soapbar/team8s/README.md

# ECE 3400: Physical Intelligent Systems 
Taught by Professor Kirstin Petersen

Fall 2018

## Team #8 : team8s
We are a group of four students working together on a semester-long physical intelligent systems project. 

### Used Bootstrap template [Half Slider](https://startbootstrap.com/template-overviews/half-slider/)
