soapbar/team8s/docs/images/box.JPG

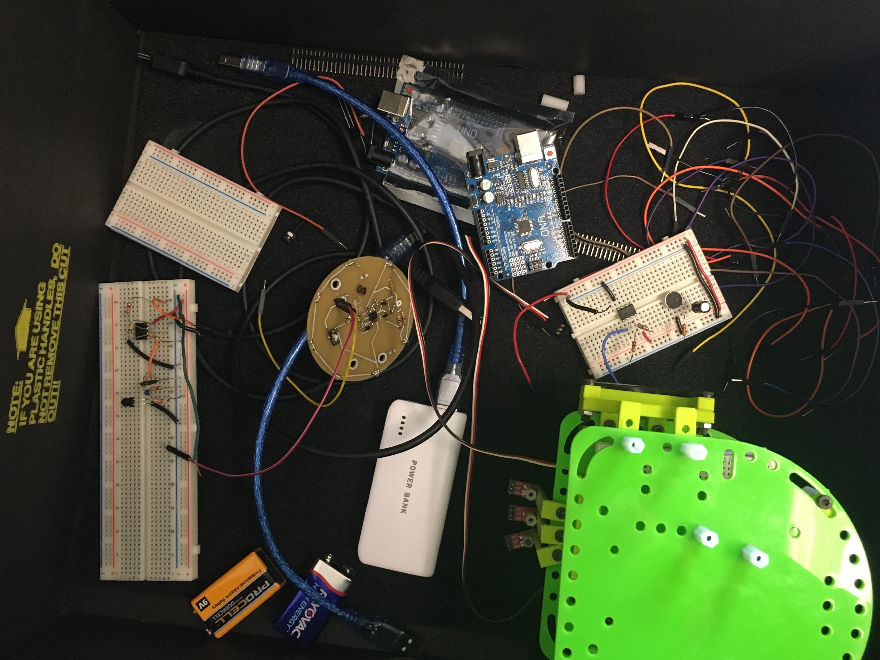
docs/images/box.JPG
