soapbar/team8s/docs/images/computers.JPG

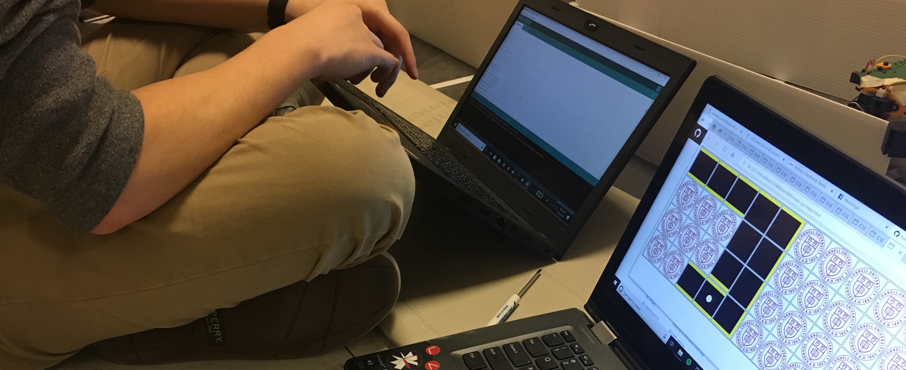
docs/images/computers.JPG
