soapbar/team8s/docs/images/current-robo.JPG

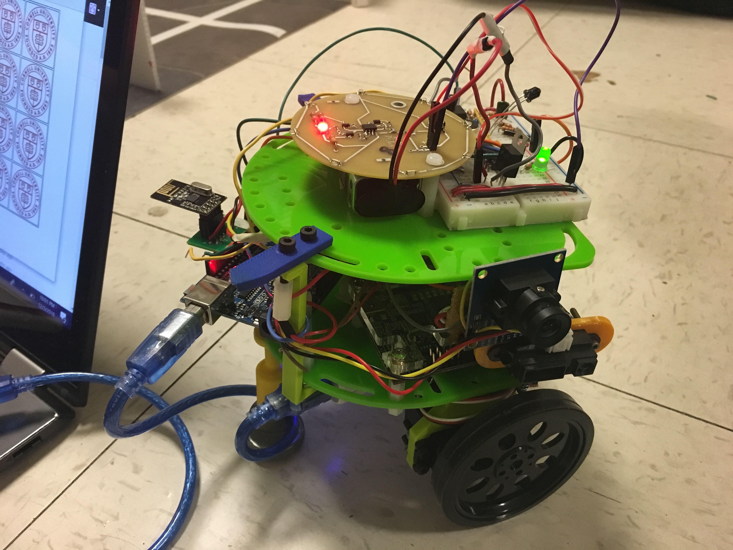
docs/images/current-robo.JPG
