soapbar/team8s/docs/images/current_robot_1120.JPG

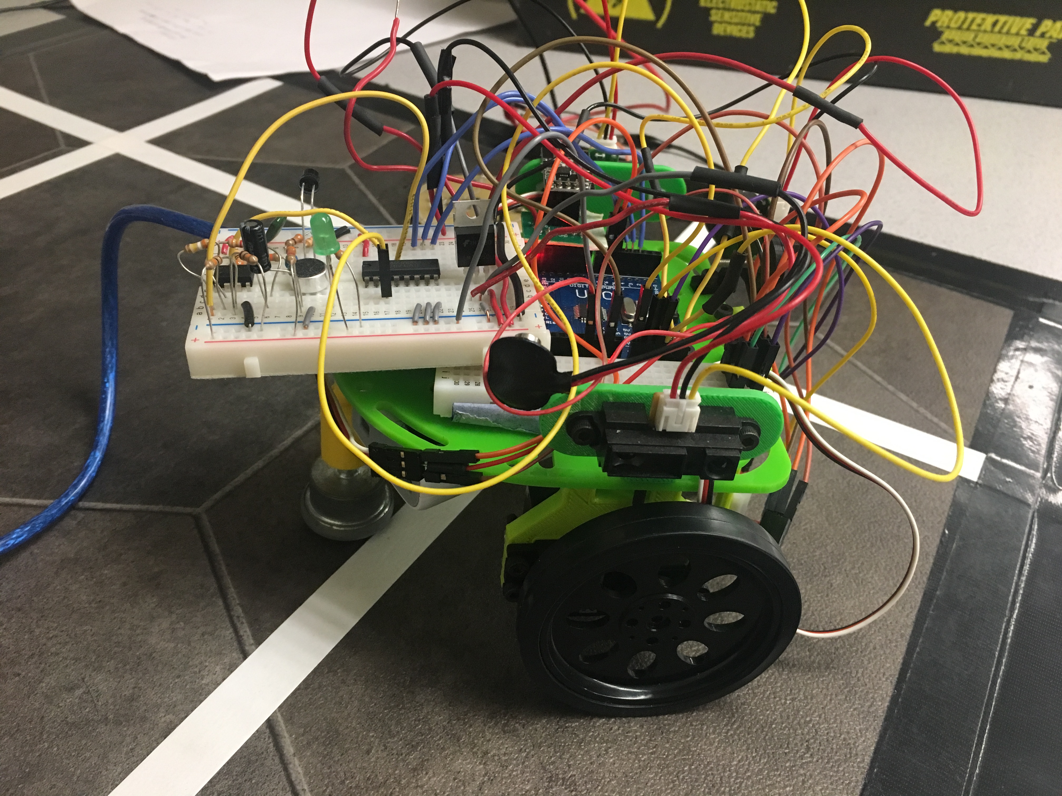
docs/images/current_robot_1120.JPG
