soapbar/team8s/docs/images/final/camera.png

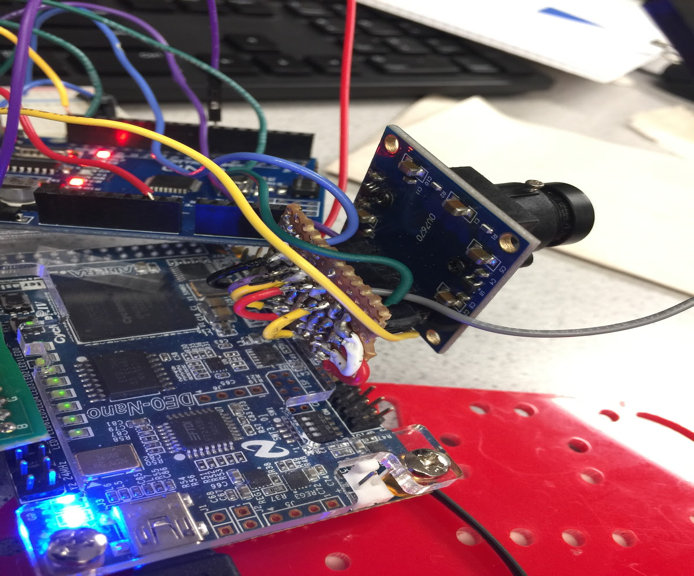
docs/images/final/camera.png
