soapbar/team8s/docs/images/final/group-pic.JPG

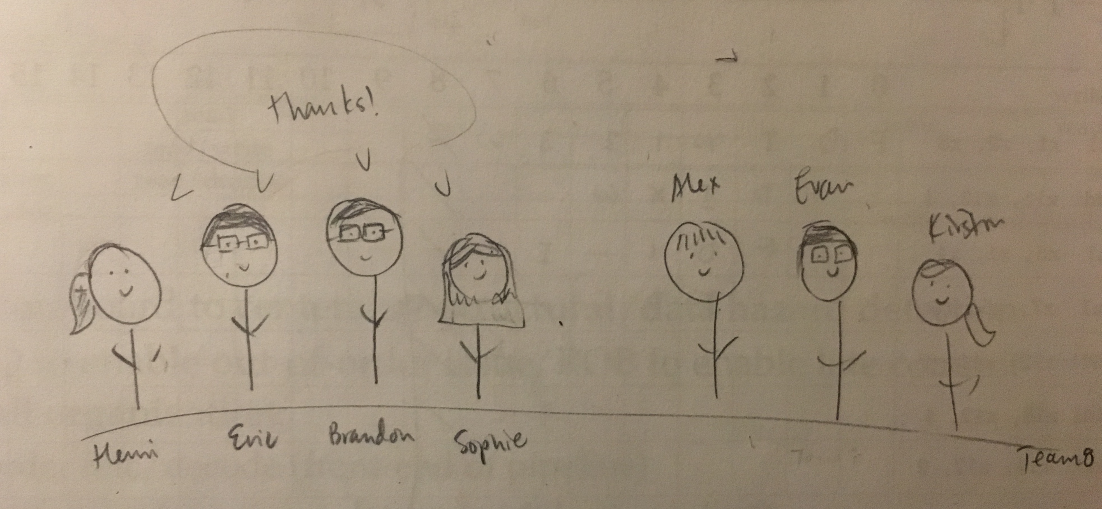
docs/images/final/group-pic.JPG
