soapbar/team8s/docs/images/final/gui-2.png

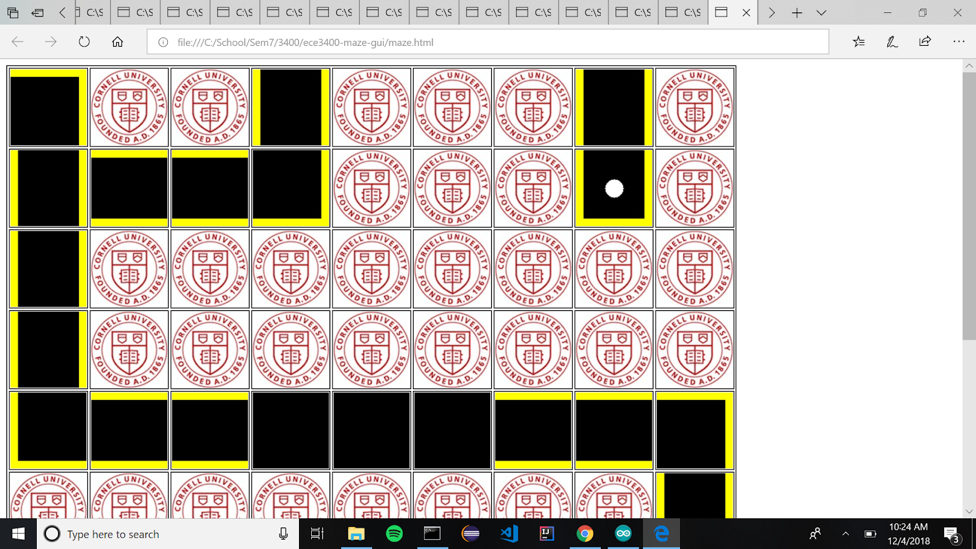
docs/images/final/gui-2.png
