soapbar/team8s/docs/images/final/ir.png

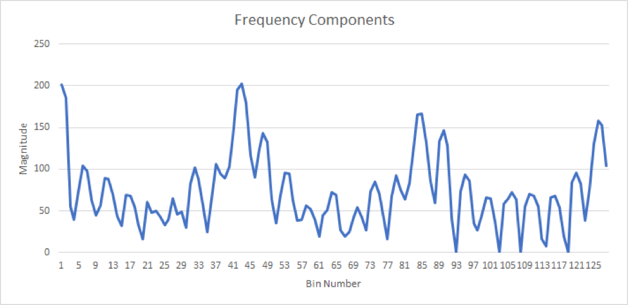
docs/images/final/ir.png
