soapbar/team8s/docs/images/final/line-following-1.png

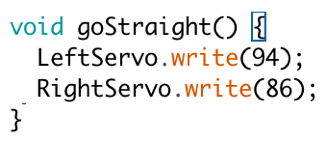
docs/images/final/line-following-1.png
