soapbar/team8s/docs/images/final/line-following.png

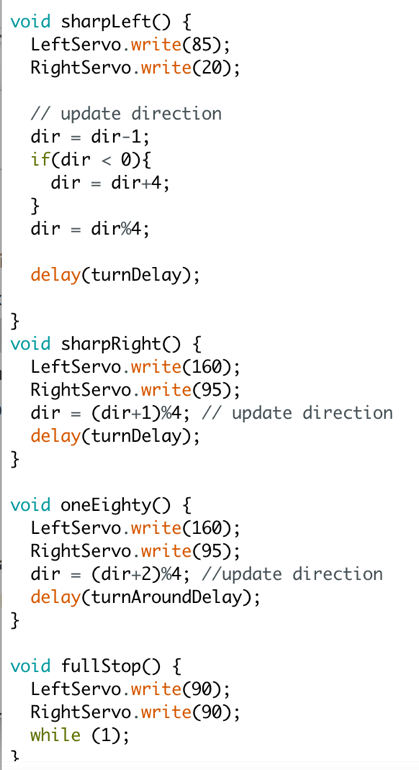
docs/images/final/line-following.png
