soapbar/team8s/docs/images/final/mic.png

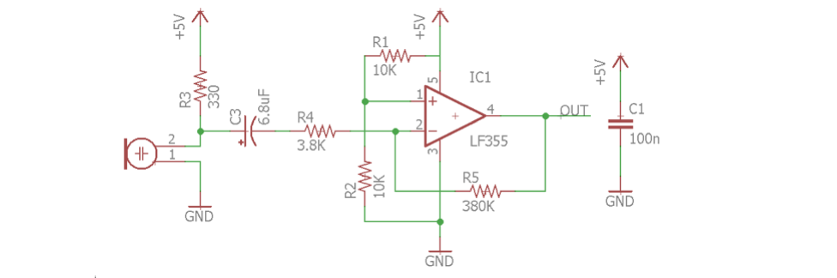
docs/images/final/mic.png
