soapbar/team8s/docs/images/final/team.png

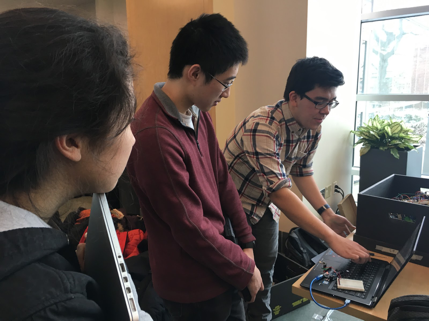
docs/images/final/team.png
