soapbar/team8s/docs/images/lab1/external_led.png

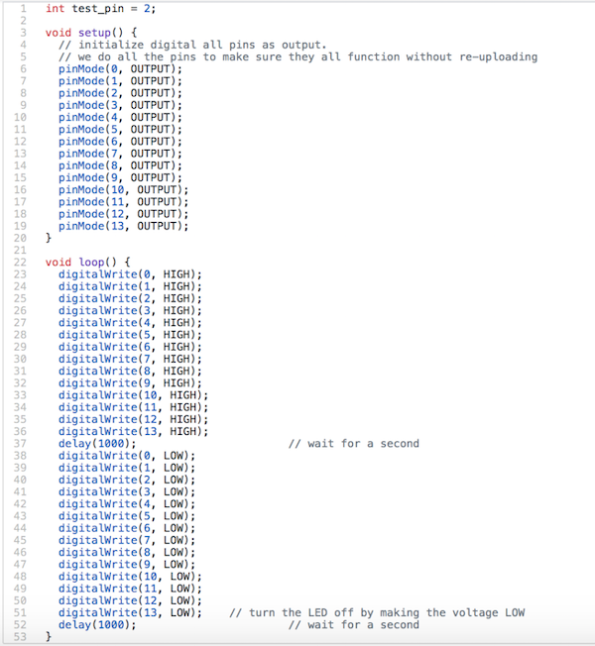
docs/images/lab1/external_led.png
