soapbar/team8s/docs/images/lab2/acoustic_diagram.png

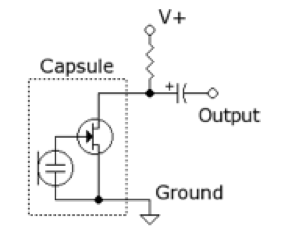
docs/images/lab2/acoustic_diagram.png
