soapbar/team8s/docs/images/lab2/acoustic_graph.png

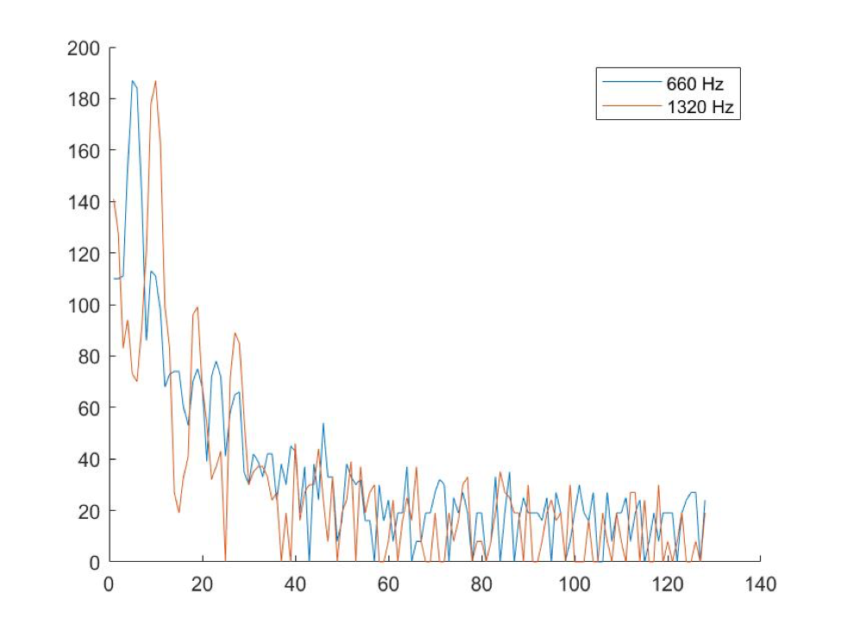
docs/images/lab2/acoustic_graph.png
