soapbar/team8s/docs/images/lab2/bandpass_filter.png

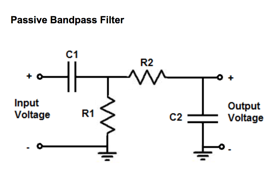
docs/images/lab2/bandpass_filter.png
