soapbar/team8s/docs/images/lab2/fft_code_detection.png

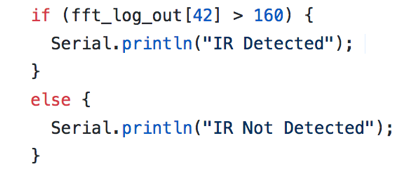
docs/images/lab2/fft_code_detection.png
