soapbar/team8s/docs/images/lab2/final_circuit.png

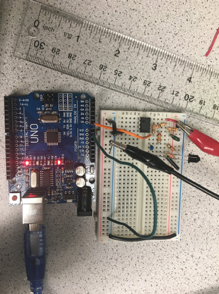
docs/images/lab2/final_circuit.png
