soapbar/team8s/docs/images/lab2/initial_circuit.png

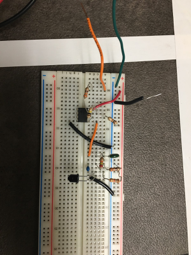
docs/images/lab2/initial_circuit.png
