soapbar/team8s/docs/images/lab2/noninverting_opamp.png

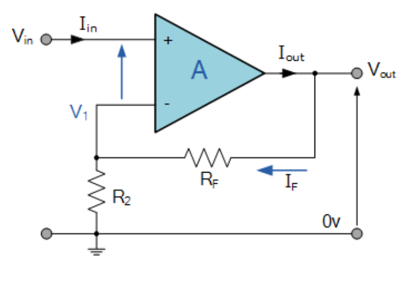
docs/images/lab2/noninverting_opamp.png
