soapbar/team8s/docs/images/lab2/pinout.png

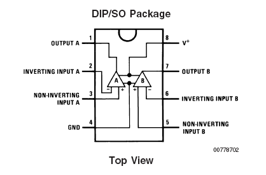
docs/images/lab2/pinout.png
