soapbar/team8s/docs/images/lab2/reposition.png

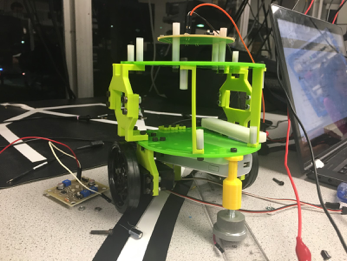
docs/images/lab2/reposition.png
