soapbar/team8s/docs/images/lab2/scope.png

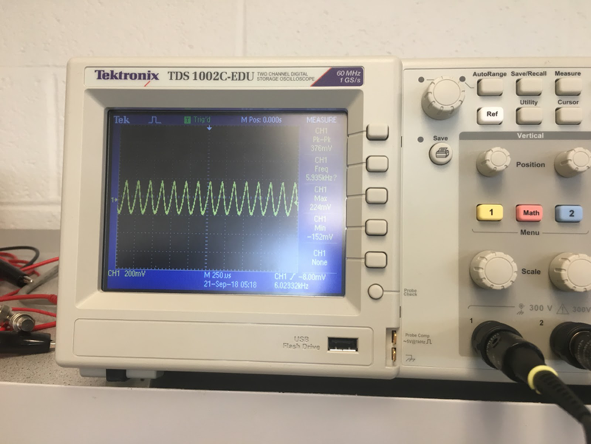
docs/images/lab2/scope.png
