soapbar/team8s/docs/images/lab4/arduino_pins.png

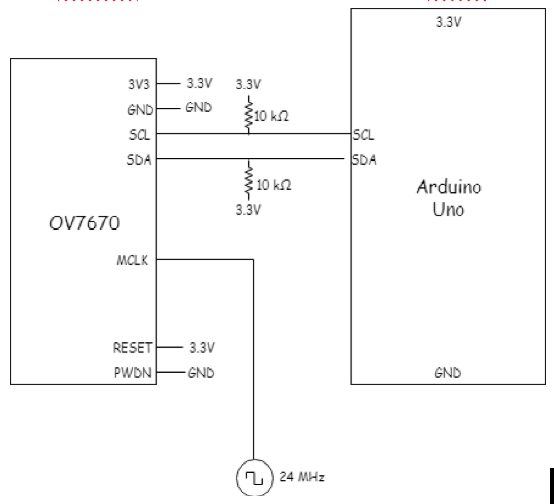
docs/images/lab4/arduino_pins.png
