soapbar/team8s/docs/images/lab4/color_bar.JPG

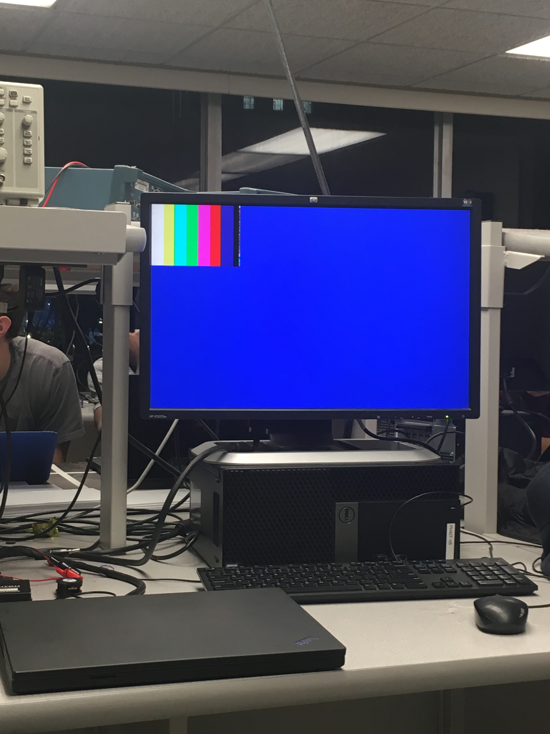
docs/images/lab4/color_bar.JPG
