soapbar/team8s/docs/images/lab4/flag-camera.png

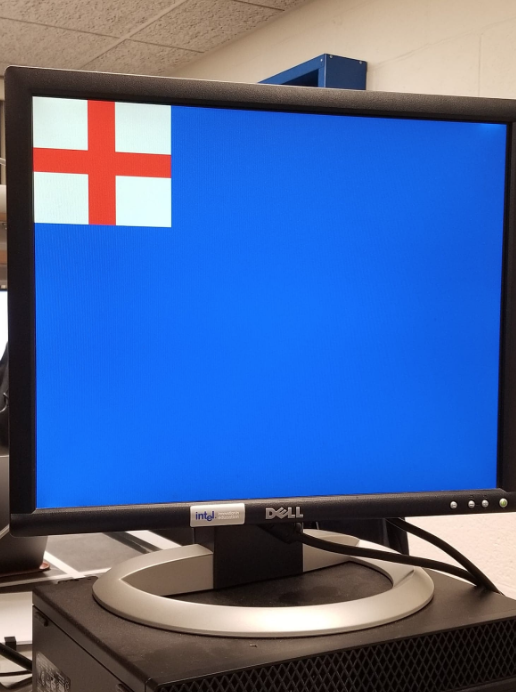
docs/images/lab4/flag-camera.png
