soapbar/team8s/docs/images/lab4/frame-sync.png

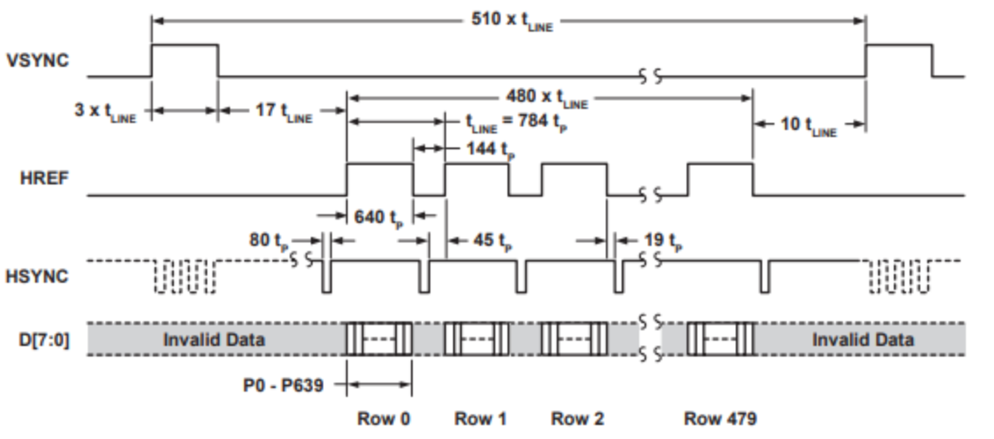
docs/images/lab4/frame-sync.png
