soapbar/team8s/docs/images/lab4/pixel-data-code.png

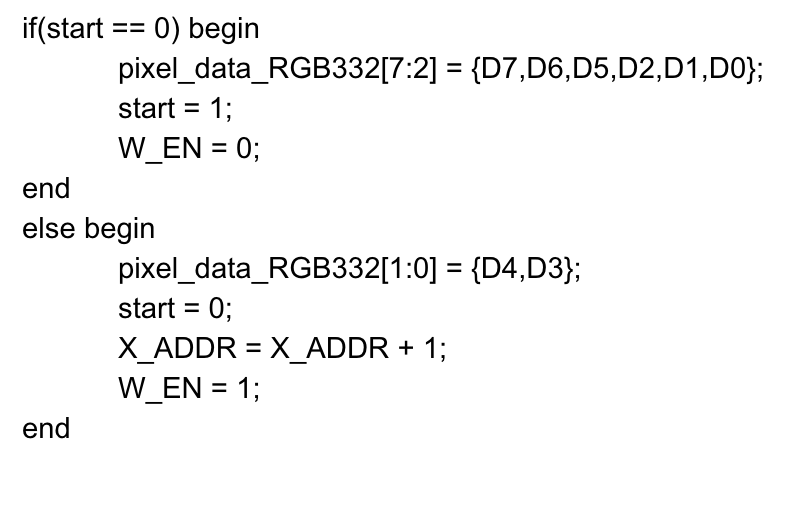
docs/images/lab4/pixel-data-code.png
