soapbar/team8s/docs/images/lab4/red-blue-pixel-code.png

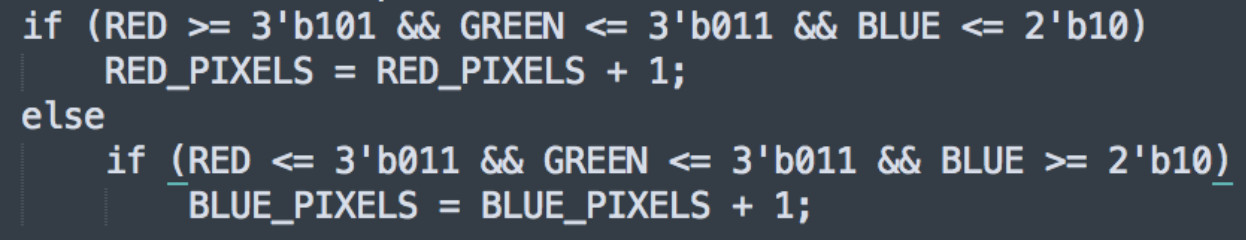
docs/images/lab4/red-blue-pixel-code.png
