soapbar/team8s/docs/images/lab4/timing-diagram.png

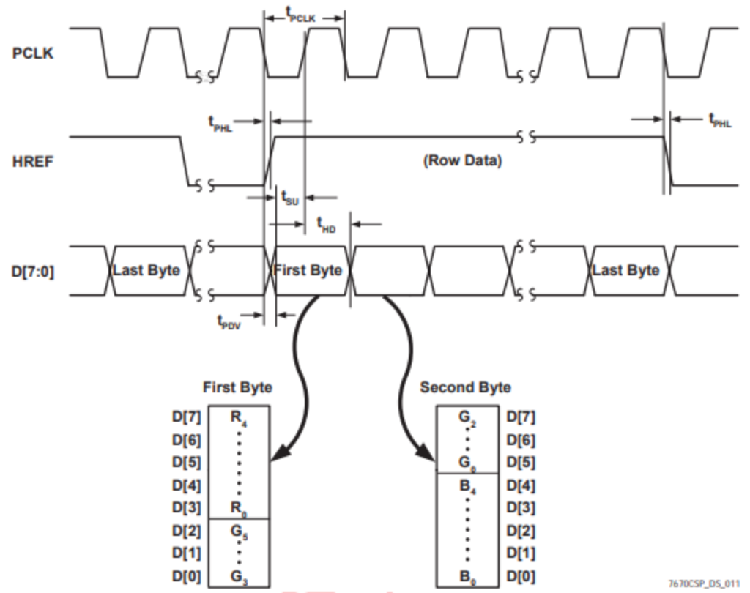
docs/images/lab4/timing-diagram.png
