soapbar/team8s/docs/images/lab.JPG

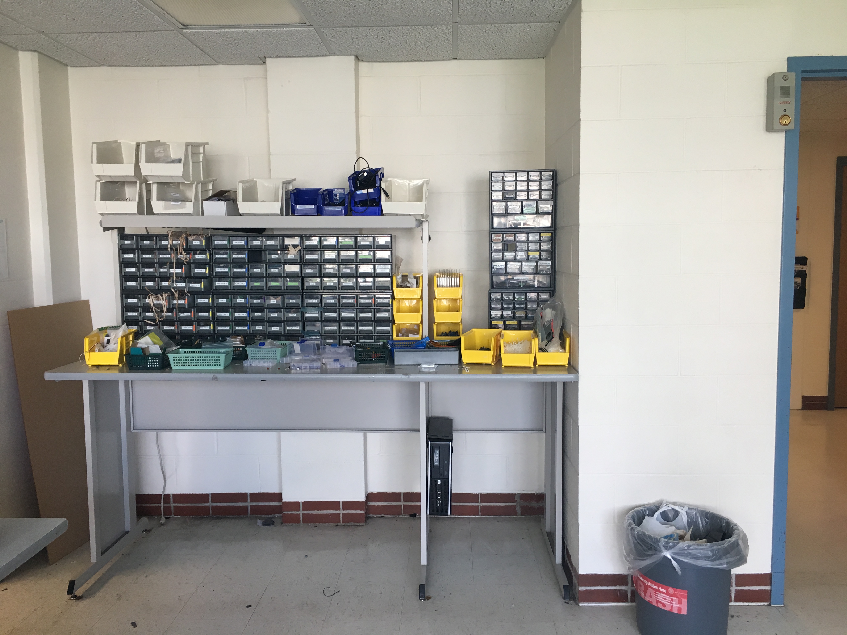
docs/images/lab.JPG
