soapbar/team8s/docs/images/milestone1/figure8_code.png

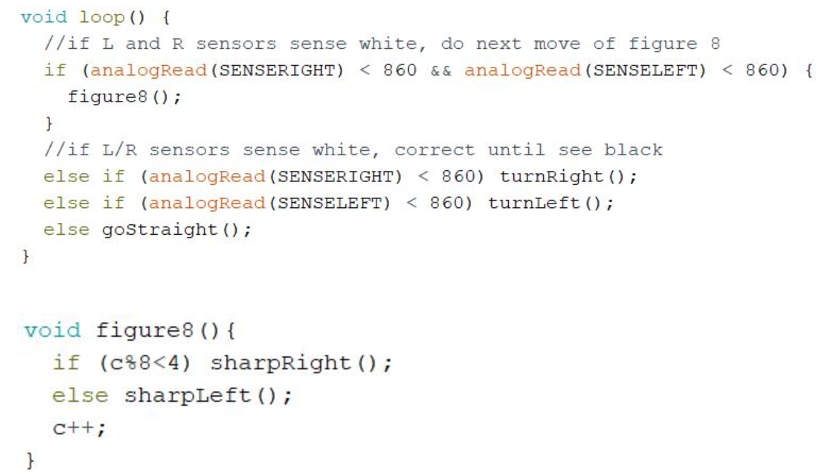
docs/images/milestone1/figure8_code.png
