soapbar/team8s/docs/images/milestone3/dfs-1.png

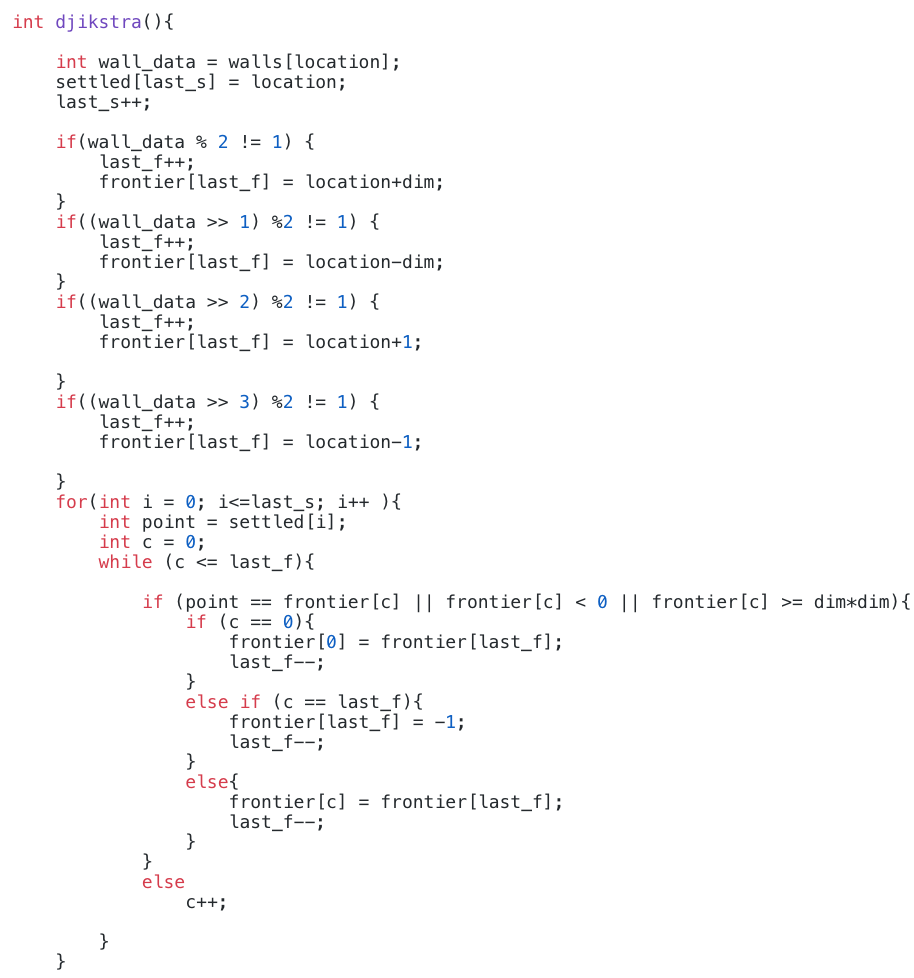
docs/images/milestone3/dfs-1.png
