soapbar/team8s/docs/images/milestone3/dfs-2.png

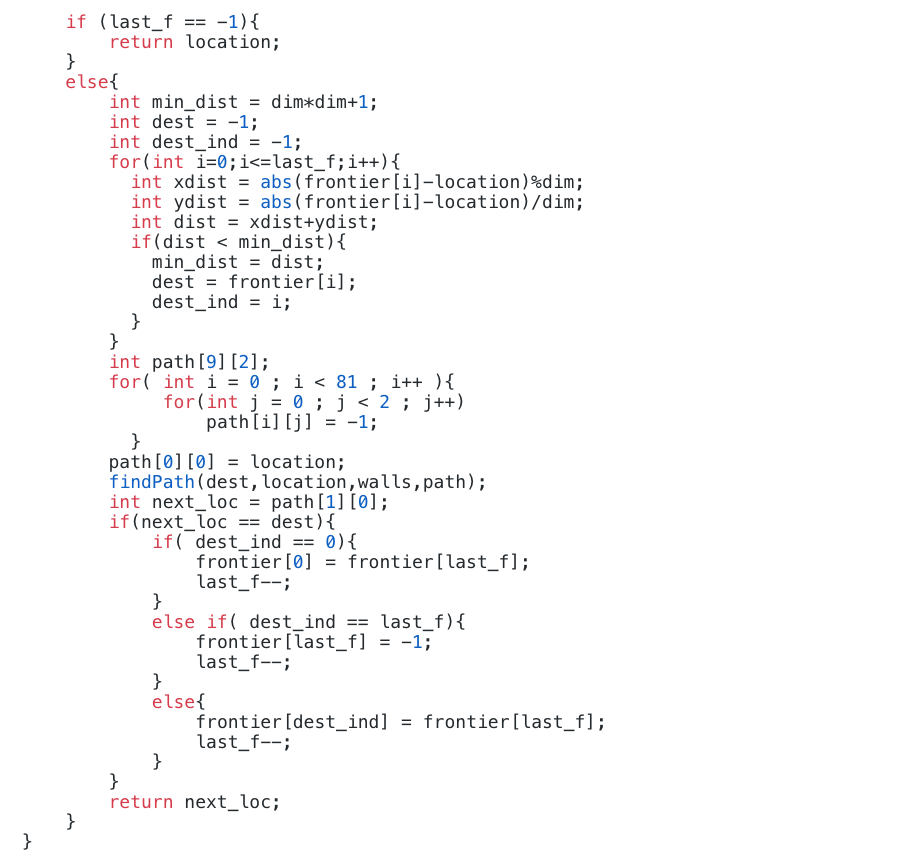
docs/images/milestone3/dfs-2.png
