soapbar/team8s/docs/images/milestone4/camera-part-1.JPG

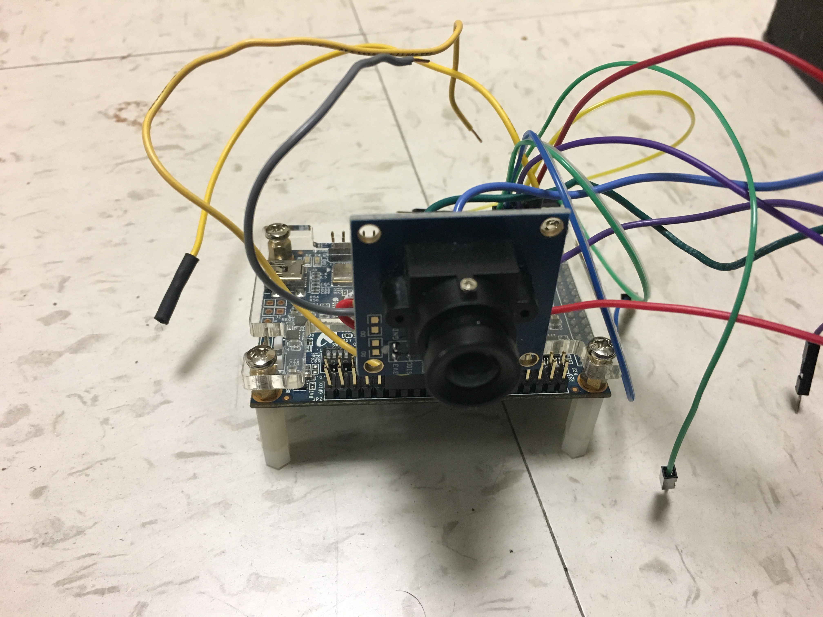
docs/images/milestone4/camera-part-1.JPG
