soapbar/team8s/docs/images/milestone4/camera-part-2.JPG

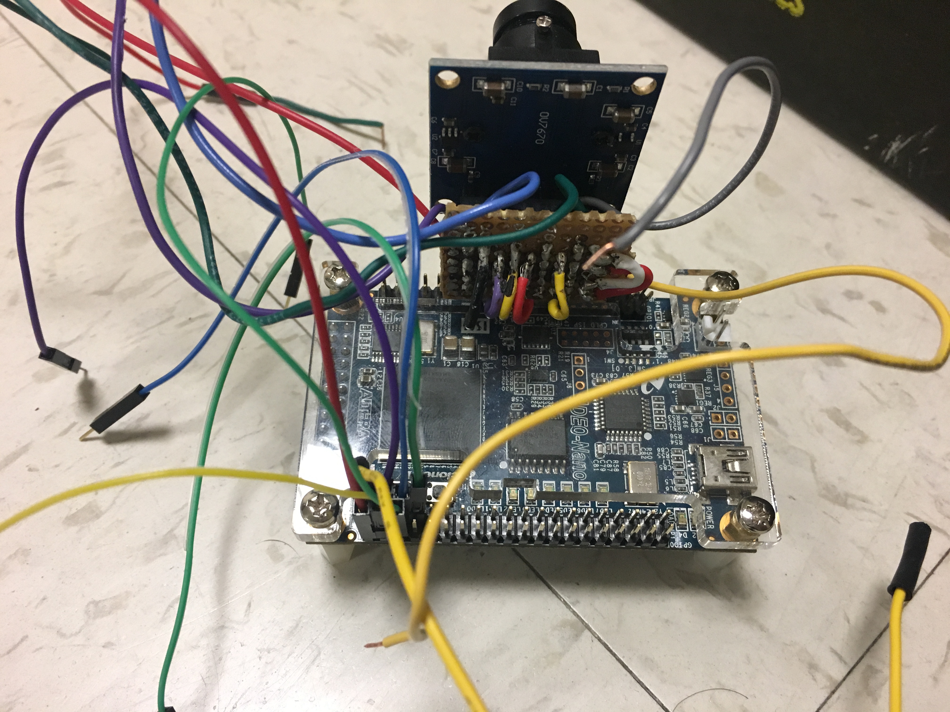
docs/images/milestone4/camera-part-2.JPG
