soapbar/team8s/docs/images/random-pics/brandon-walking.JPG

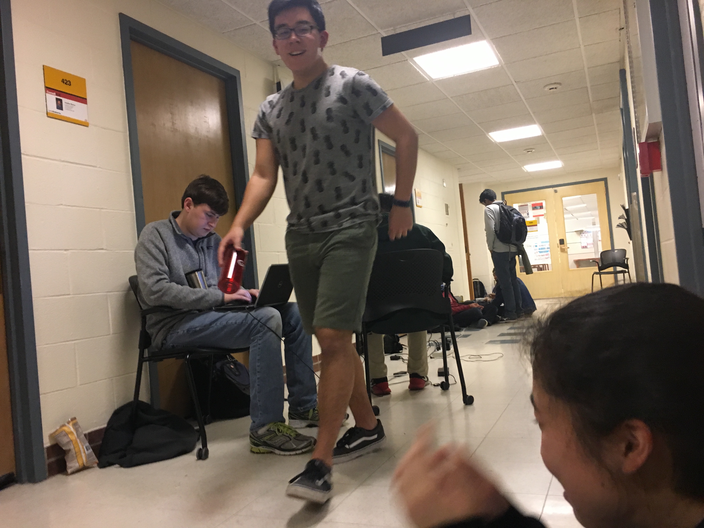
docs/images/random-pics/brandon-walking.JPG
