soapbar/team8s/docs/images/random-pics/eric.JPG

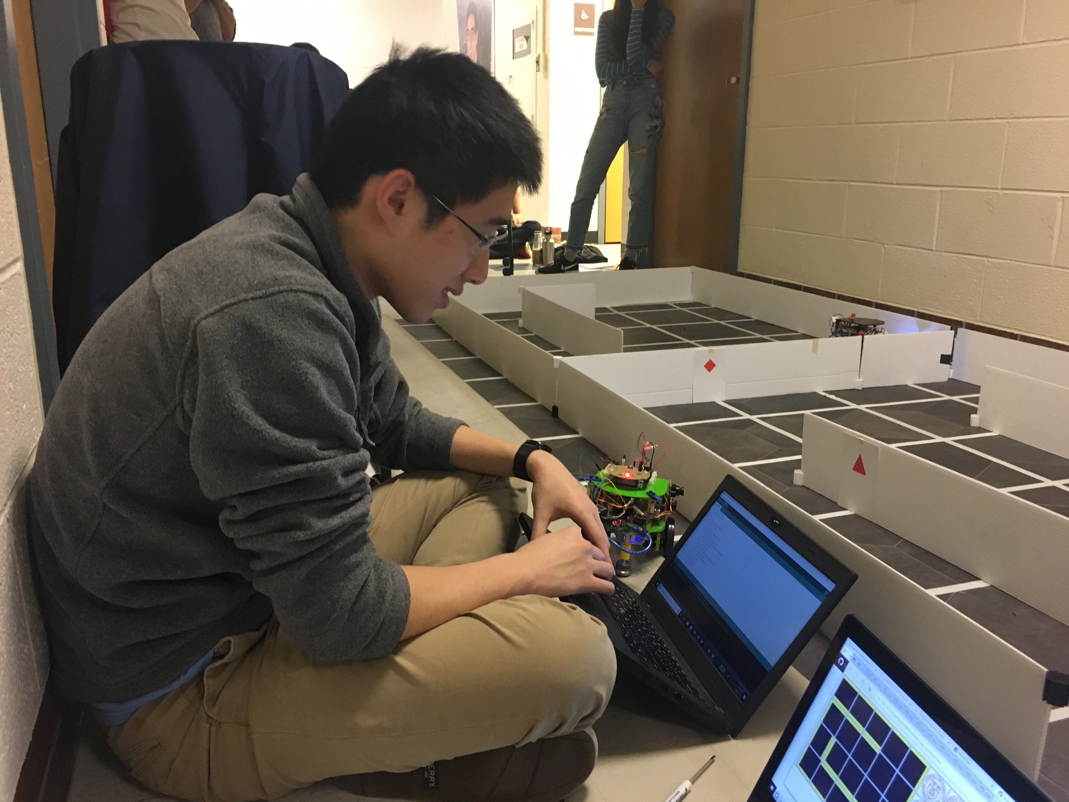
docs/images/random-pics/eric.JPG
