soapbar/team8s/docs/images/random-pics/henri.JPG

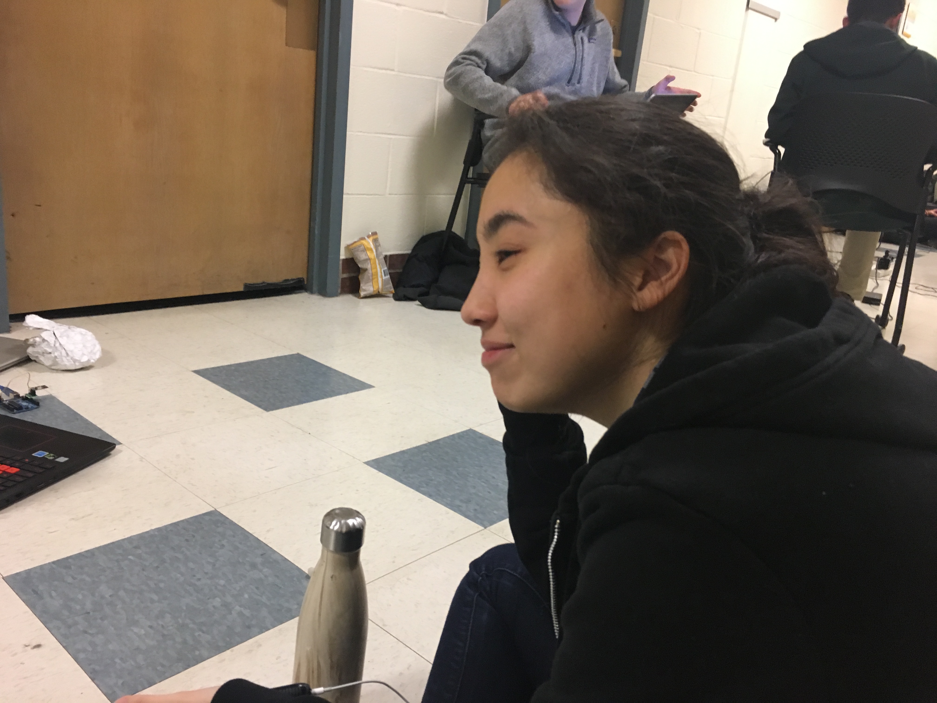
docs/images/random-pics/henri.JPG
