soapbar/team8s/docs/images/robot.JPG

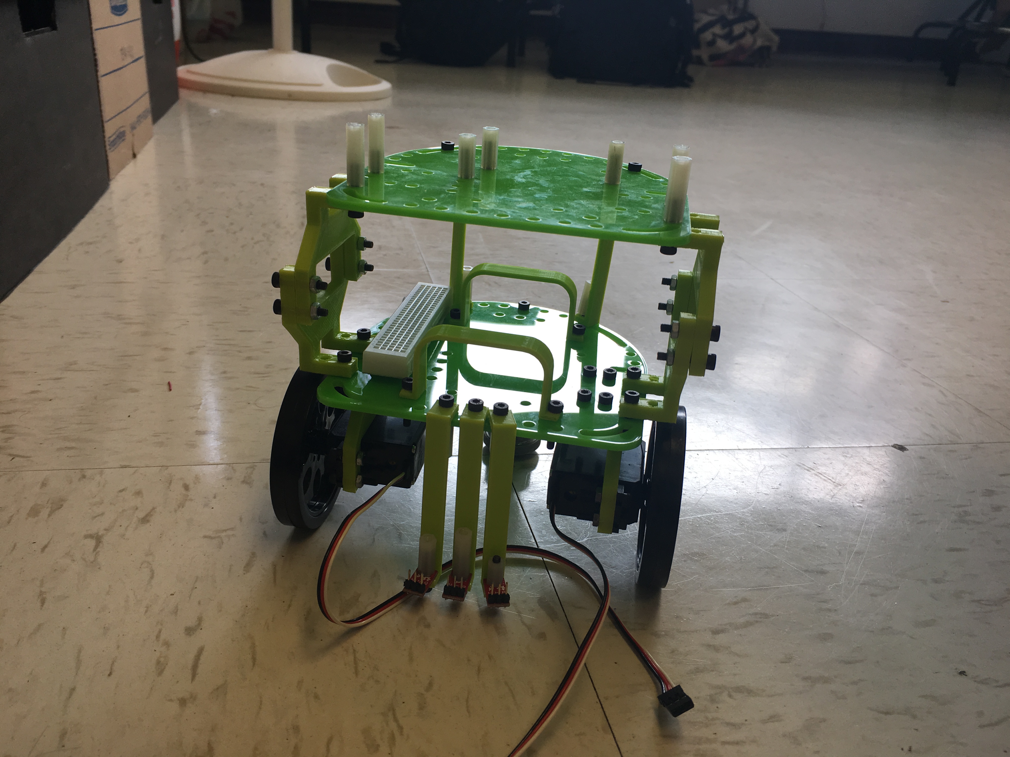
docs/images/robot.JPG
