soapbar/team8s/docs/images/team/brandon.jpg

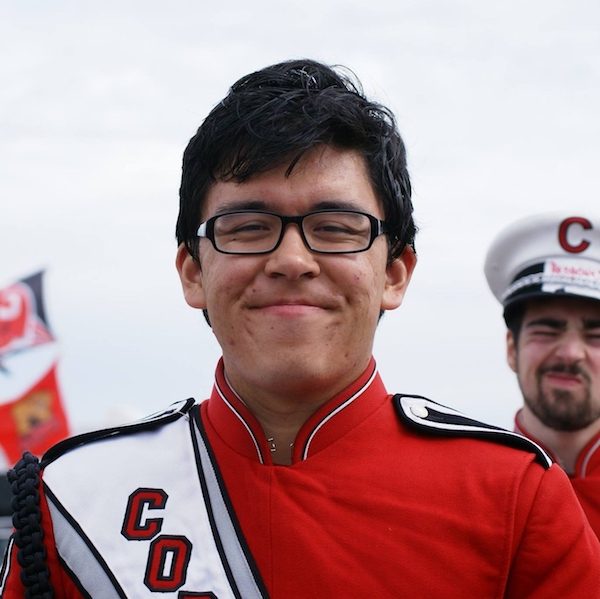
docs/images/team/brandon.jpg
