soapbar/team8s/docs/images/team/eric.jpg

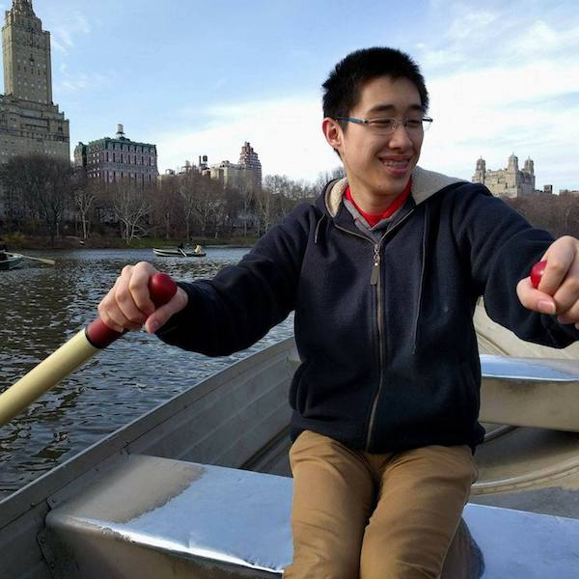
docs/images/team/eric.jpg
