soapbar/team8s/docs/images/team/henri.jpg

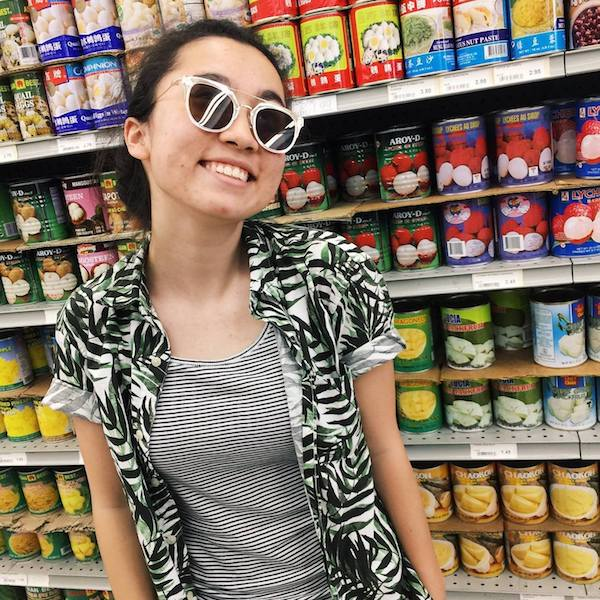
docs/images/team/henri.jpg
