soapbar/team8s/docs/images/team/sophie.jpg

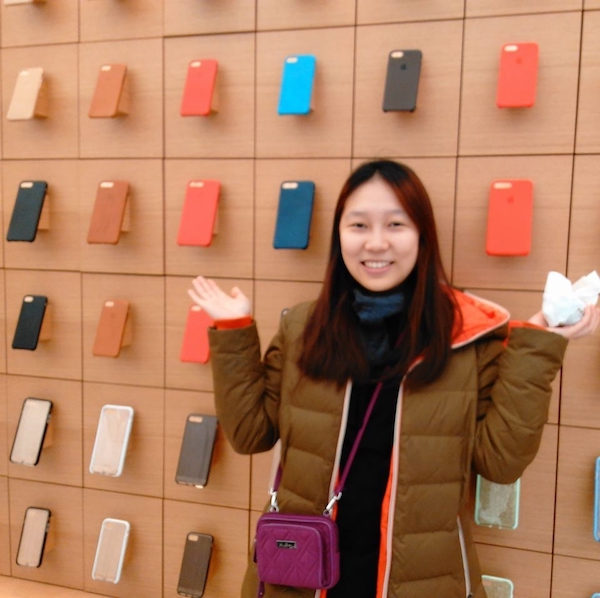
docs/images/team/sophie.jpg
