soapbar/team8s/docs/images/traversalCode.png

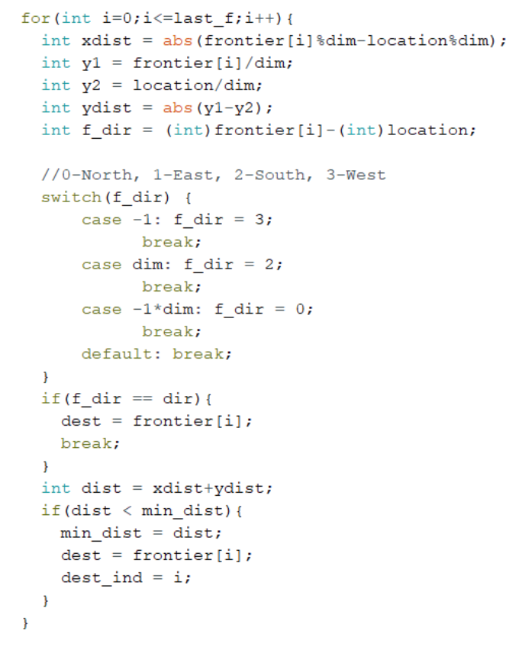
docs/images/traversalCode.png
