soapbar/team8s/docs/images/workingTraversal.png

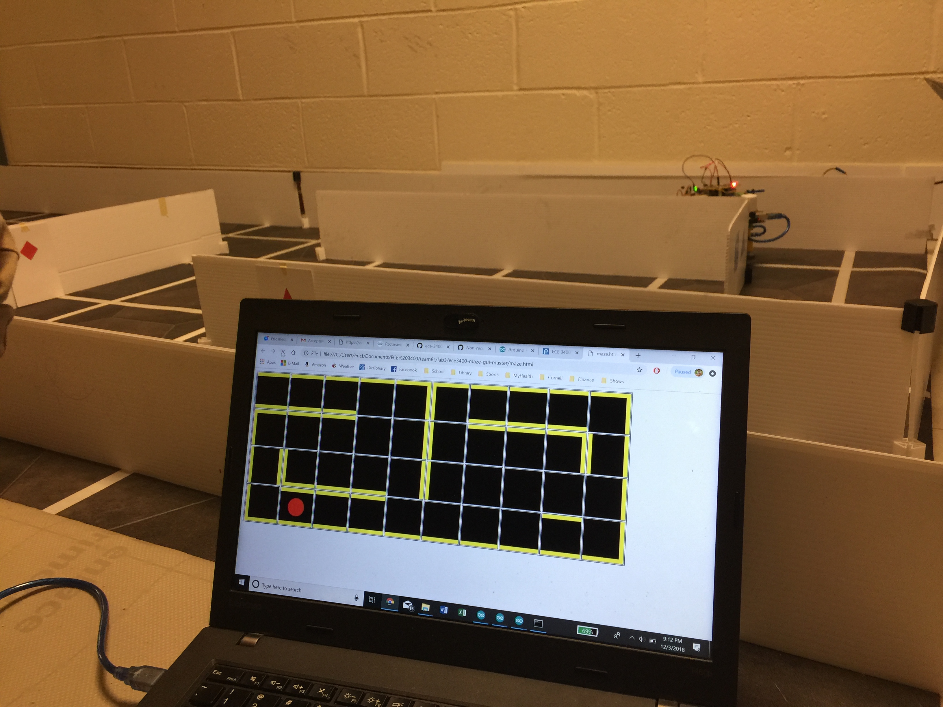
docs/images/workingTraversal.png
