soapbar/team8s/docs/images/final/cost.png

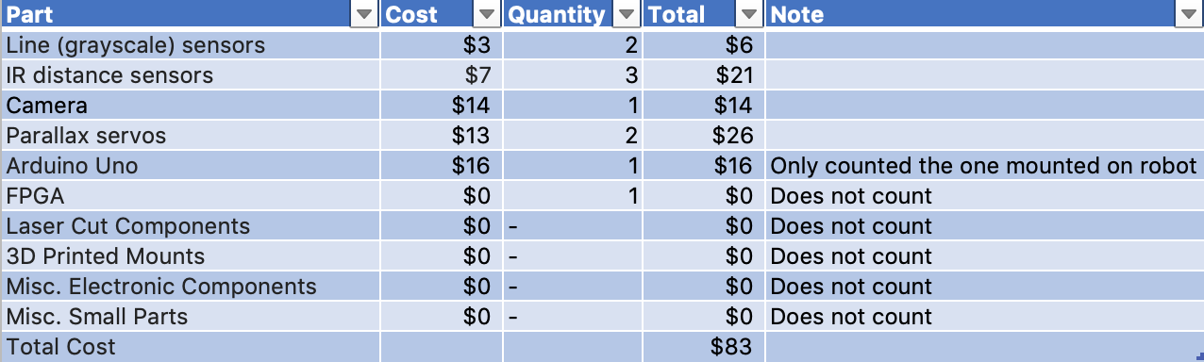
docs/images/final/cost.png
