soapbar/team8s/docs/images/lab2/frequency_components.png

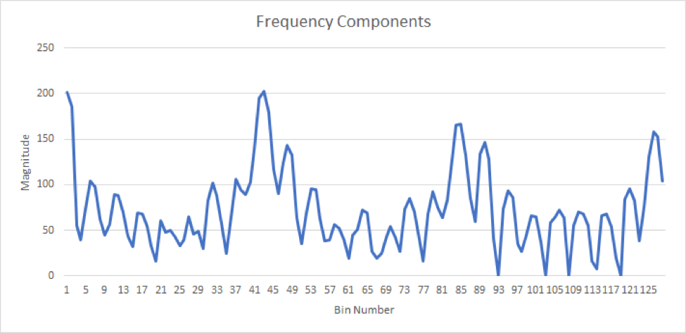
docs/images/lab2/frequency_components.png
