soapbar/team8s/docs/images/lab4/testing_color_bar.JPG

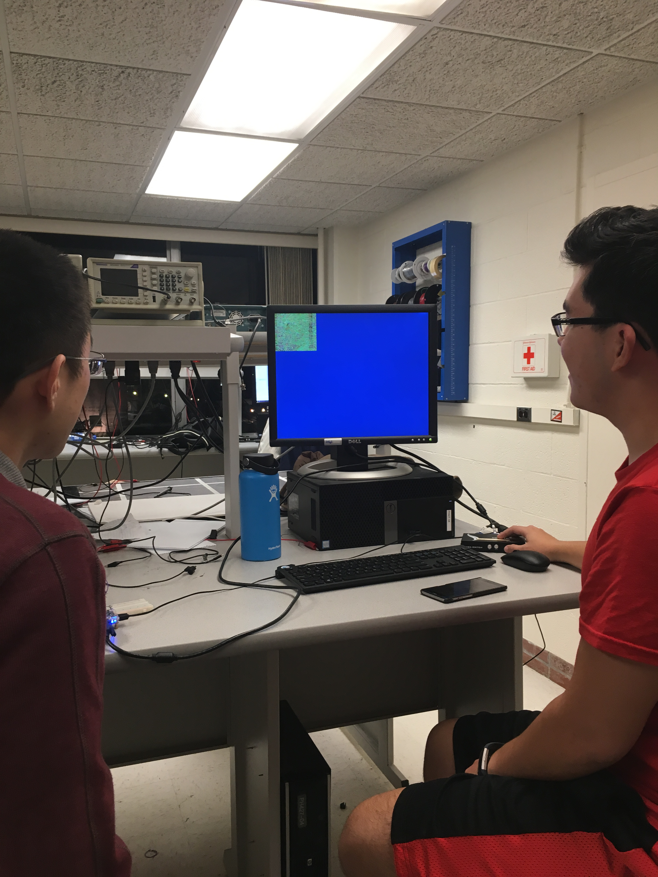
docs/images/lab4/testing_color_bar.JPG
