soapbar/team8s/docs/images/random-pics/debugging-rip.JPG

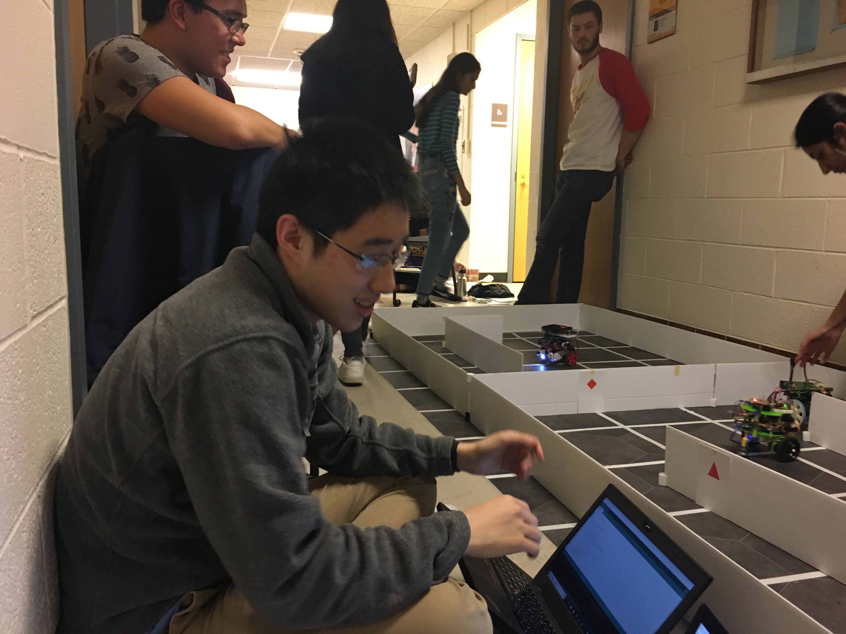
docs/images/random-pics/debugging-rip.JPG
