soapbar/team8s/lab4/Lab4_Arduino_Template/OV7670_SETUP/OV7670_SETUP.ino

#include <Wire.h>

#define OV7670_I2C_ADDRESS 0x21 /*TODO: write this in hex (eg. 0xAB) */

//registers
#define COM7 0x12
#define COM3 0x0C
#define CLKRC 0x11
#define COM15 0x40
#define COM17 0x42
#define MVFP 0x1E
#define COM9 0x14

//#define PSHFT 0x1B

int diff0 = 2;
int diff1 = 3;
int diff2 = 4;
int diff3 = 5;
int diff4 = 6;
int diff5 = 7;
int colorPin = 8;
int nonePin = 9;
int sp1 = 10;
///////// Main Program //////////////
void setup() {
  Wire.begin();
  Serial.begin(9600);
  
  // TODO: WRITE KEY REGISTERS
  // camera
  OV7670_write_register(COM7, 0x80); // Reset the registers 
  delay(100);
  set_color_matrix();


  OV7670_write_register(COM3, 0x08); // Scaling enable
  OV7670_write_register(CLKRC, 0xC0); // use external clock as internal bit 3 + enable double clock / 80?
  OV7670_write_register(COM15, 0xD0); // RGB 565 output F0 + largest outut range // F0 / D0
  OV7670_write_register(COM7, 0x0C); // RGB output, no color bar enabled, QCIF selection
  //OV7670_write_register(COM7, 0x0E); // COLOR - RGB output, yes color bar enabled, QCIF selection
  //OV7670_write_register(COM17, 0x08); // COLOR - dsp color bar enabled 
  OV7670_write_register(MVFP, 0x30); // mirror and flipped
  OV7670_write_register(COM9, 0xB); // gain 2x + freeze AGC/AEC 



  // TODO: READ KEY REGISTERS
  read_key_registers();

  pinMode(diff0, INPUT);
  pinMode(diff1, INPUT);
  pinMode(diff2, INPUT);
  pinMode(diff3, INPUT);
  pinMode(diff4, INPUT);
  pinMode(diff5, INPUT);
  pinMode(colorPin, INPUT);
  pinMode(nonePin, INPUT);
  pinMode(sp1, INPUT);
}

void loop(){
  if (digitalRead(nonePin) == HIGH) {
    Serial.println("None");
  }
  else {
    if (digitalRead(colorPin) == LOW) {
      Serial.println("Red");
    }
    else {
      Serial.println("Blue");
    }
  }
  delay(1000);
}


///////// Function Definition //////////////
void read_key_registers(){
  /*TODO: DEFINE THIS FUNCTION*/
  Serial.println(read_register_value(COM7), HEX);
  Serial.println(read_register_value(COM3), HEX);
  Serial.println(read_register_value(CLKRC), HEX);
  Serial.println(read_register_value(COM15), HEX);
  //read_register_value(COM17);
  Serial.println(read_register_value(MVFP), HEX);
  Serial.println(read_register_value(COM9), HEX);
  
}


byte read_register_value(int register_address){
  byte data = 0;
  Wire.beginTransmission(OV7670_I2C_ADDRESS);
  Wire.write(register_address);
  Wire.endTransmission();
  Wire.requestFrom(OV7670_I2C_ADDRESS,1);
  while(Wire.available()<1);
  data = Wire.read();
  return data;
}

String OV7670_write(int start, const byte *pData, int size){
    int n,error;
    Wire.beginTransmission(OV7670_I2C_ADDRESS);
    n = Wire.write(start);
    if(n != 1){
      return "I2C ERROR WRITING START ADDRESS";   
    }
    n = Wire.write(pData, size);
    if(n != size){
      return "I2C ERROR WRITING DATA";
    }
    error = Wire.endTransmission(true);
    if(error != 0){
      return String(error);
    }
    return "no errors :)";
 }

String OV7670_write_register(int reg_address, byte data){
  return OV7670_write(reg_address, &data, 1);
 }

void set_color_matrix(){
    OV7670_write_register(0x4f, 0x80);
    OV7670_write_register(0x50, 0x80);
    OV7670_write_register(0x51, 0x00);
    OV7670_write_register(0x52, 0x22);
    OV7670_write_register(0x53, 0x5e);
    OV7670_write_register(0x54, 0x80);
    OV7670_write_register(0x56, 0x40);
    OV7670_write_register(0x58, 0x9e);
    OV7670_write_register(0x59, 0x88);
    OV7670_write_register(0x5a, 0x88);
    OV7670_write_register(0x5b, 0x44);
    OV7670_write_register(0x5c, 0x67);
    OV7670_write_register(0x5d, 0x49);
    OV7670_write_register(0x5e, 0x0e);
    OV7670_write_register(0x69, 0x00);
    OV7670_write_register(0x6a, 0x40);
    OV7670_write_register(0x6b, 0x0a);
    OV7670_write_register(0x6c, 0x0a);
    OV7670_write_register(0x6d, 0x55);
    OV7670_write_register(0x6e, 0x11);
    OV7670_write_register(0x6f, 0x9f);
    OV7670_write_register(0xb0, 0x84);
}
