soapbar/team8s/milestone1/FigureEight/FigureEight.ino

// line following robot: follows white line (against dark background)
// does a figure 8

#include <Servo.h>

// wheels
Servo LeftServo;
Servo RightServo;

// wheels - output pins
int OUTLEFT = 5;
int OUTRIGHT = 6;

// line following sensors - analog input pins
// L/R on either side of line
int SENSELEFT = A2;
int SENSERIGHT = A1;

// counter
int c = 0;


void setup() {
  LeftServo.attach(OUTLEFT);
  RightServo.attach(OUTRIGHT);
  Serial.begin(9600);
}

void loop() {  
  // if L/R sensors sense white, correct until see black
  if (analogRead(SENSERIGHT) < 860 && analogRead(SENSELEFT) < 860) { // intersection
    figure8();
  } 
  // line following
  else if (analogRead(SENSERIGHT) < 860) {
    driftRight();
  }       
  else if (analogRead(SENSELEFT) < 860) {
    driftLeft();
  }
  else { // go straight
    goStraight();
  }
}

void figure8(){
  Serial.println("start figure 8");

  if (c%8<4) {
    sharpRight();
  } else {
    sharpLeft();
  }
  c++;
}

void goStraight(){
  LeftServo.write(93);
  RightServo.write(87);
}
void driftLeft() {
  LeftServo.write(90);
  RightServo.write(50);
}

void driftRight() {
  LeftServo.write(130);
  RightServo.write(90);
}

void fullStop(){
  LeftServo.write(90);
  RightServo.write(90);
  while(1);
}

void sharpLeft(){
  LeftServo.write(85); 
  RightServo.write(20);
  digitalWrite(LED_BUILTIN, HIGH);
  delay(800); //300
  digitalWrite(LED_BUILTIN, LOW);

}

void sharpRight(){
  LeftServo.write(160);
  RightServo.write(95);
  delay(300);
}
