soapbar/team8s/(commit log)

2018-09-11 milestone 1 - code, website
    code correction/commenting
    [LineFollowing.ino, ReadingSensors.ino]
2018-09-14 yt insert try
2018-09-20 insert videos
2018-09-25 Add code for detecting IR sensor
2018-10-06 vid attach
2018-10-21 start at 660 hz tone
2018-10-21 Work around GUI bugs
    [test.ino]
2018-10-28 Updated Lab 3 with Left Wall Sensor and 660 Hz start tone
2018-10-28 Updated wall sensor threshold values
2018-10-30 lab 4 team arduino code
2018-11-01 arduino code
2018-11-03 update arduino
2018-11-03 tried stuff still does not work
    [DE0_NANO.v]
2018-11-05 Camera kinda works now
2018-11-05 arduino code -color bar
2018-11-06 Change camera to use RGB565
2018-11-20 added current robot pic
2018-11-27 Update arduino camera code
2018-11-27 Change shape frame overflow logic
2018-11-29 Changes to camera Arduino code
2018-12-06 changes to future improvements + matlab code to arduino
